Sanskar201/4-DOF-Robot-With-End-Manipulator/CAD Model/RoboticArm_4DOF/Railbase1.SLDPRT

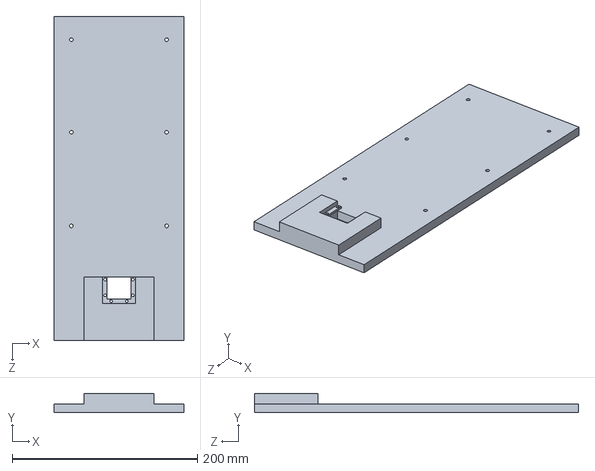
[picture p12: CAD file, 2024-12-22]
CAD Model/RoboticArm_4DOF/Railbase1.SLDPRT
140.0 x 20.7 x 350.0 mm
