Sanskar201/4-DOF-Robot-With-End-Manipulator/CAD Model/RoboticArm_4DOF/arm1.SLDPRT

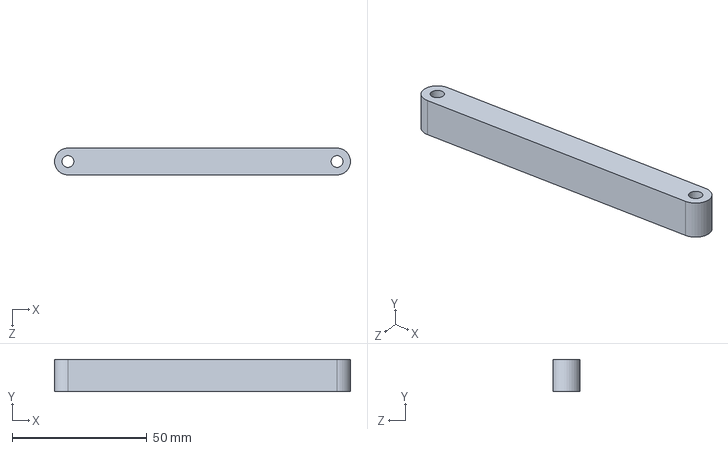
[picture p13: CAD file, 2024-12-22]
CAD Model/RoboticArm_4DOF/arm1.SLDPRT
110.0 x 12.0 x 10.0 mm
