Sanskar201/4-DOF-Robot-With-End-Manipulator/CAD Model/RoboticArm_4DOF/Gripper_Base.SLDPRT

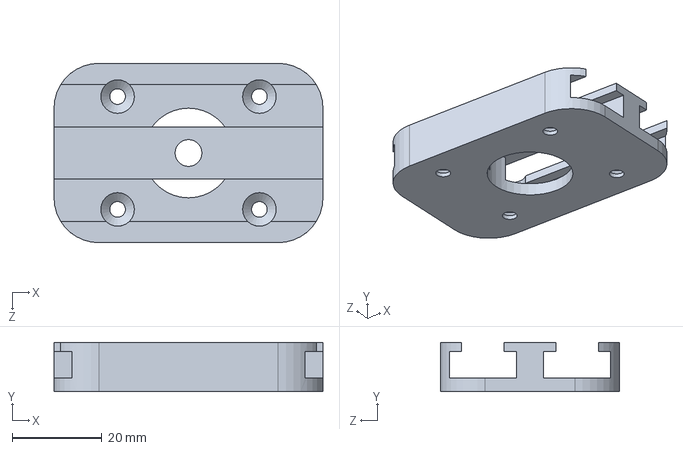
[picture p14: CAD file, 2024-12-22]
CAD Model/RoboticArm_4DOF/Gripper_Base.SLDPRT
60.0 x 11.0 x 40.0 mm
