Sanskar201/4-DOF-Robot-With-End-Manipulator/CAD Model/RoboticArm_4DOF/Pivot.SLDPRT

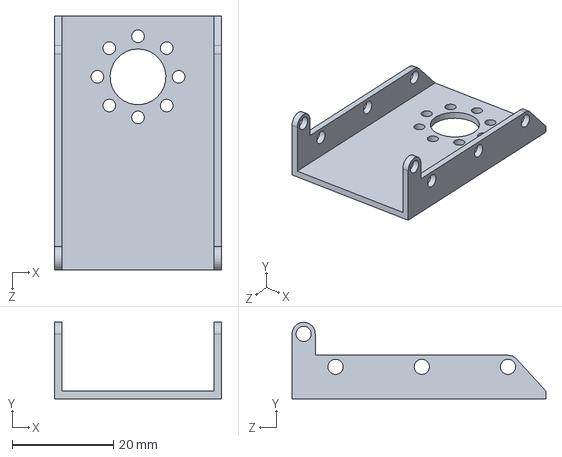
[picture p15: CAD file, 2024-12-22]
CAD Model/RoboticArm_4DOF/Pivot.SLDPRT
33.0 x 15.1 x 50.1 mm
