Sanskar201/4-DOF-Robot-With-End-Manipulator/CAD Model/RoboticArm_4DOF/Gripper_Link.SLDPRT

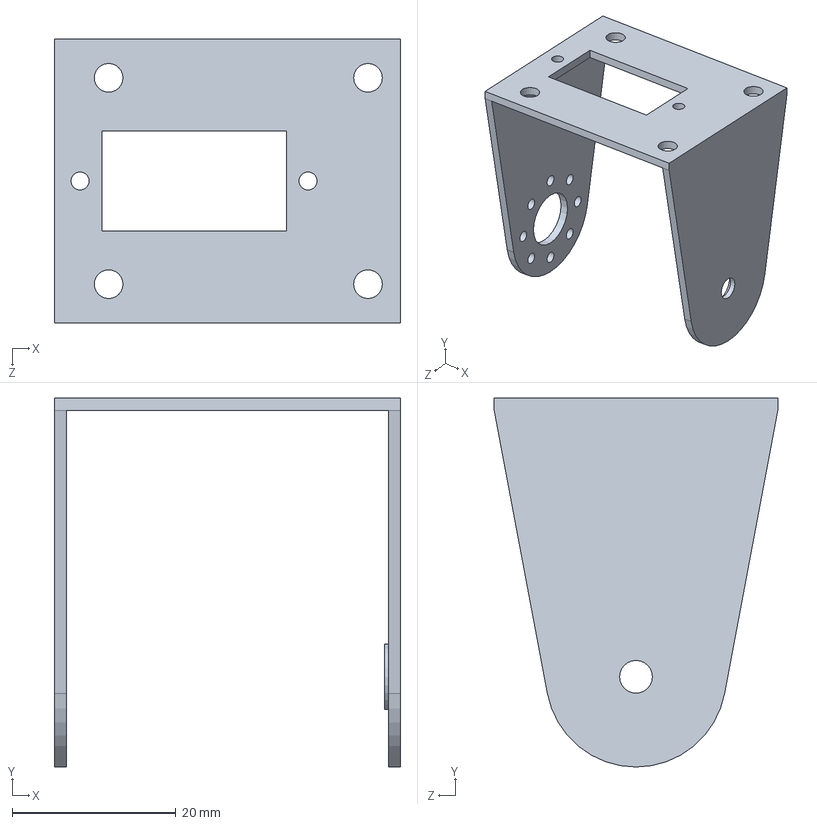
[picture p16: CAD file, 2024-12-22]
CAD Model/RoboticArm_4DOF/Gripper_Link.SLDPRT
42.2 x 45.0 x 34.6 mm
