Sanskar201/4-DOF-Robot-With-End-Manipulator/CAD Model/RoboticArm_4DOF/ServoSpacer.SLDPRT

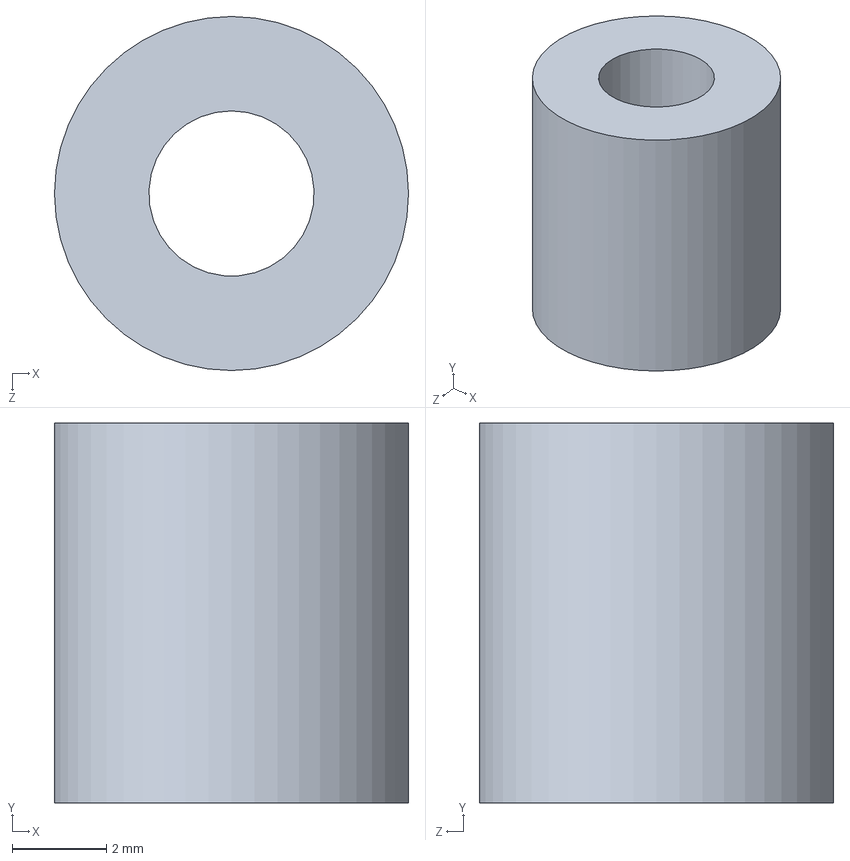
[picture p17: CAD file, 2024-12-22]
CAD Model/RoboticArm_4DOF/ServoSpacer.SLDPRT
7.50 x 8.05 x 7.50 mm
