Sanskar201/4-DOF-Robot-With-End-Manipulator/CAD Model/RoboticArm_4DOF/Gripper_rack1.SLDPRT

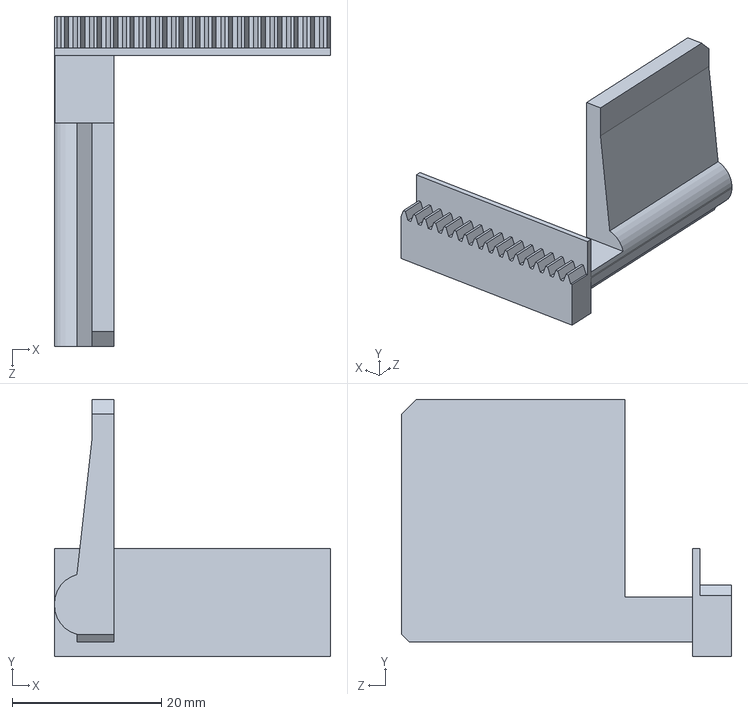
[picture p18: CAD file, 2024-12-22]
CAD Model/RoboticArm_4DOF/Gripper_rack1.SLDPRT
37.0 x 34.5 x 44.2 mm
