Sanskar201/4-DOF-Robot-With-End-Manipulator/CAD Model/RoboticArm_4DOF/SG90 - Micro Servo 9g - Tower Pro.1.SLDPRT

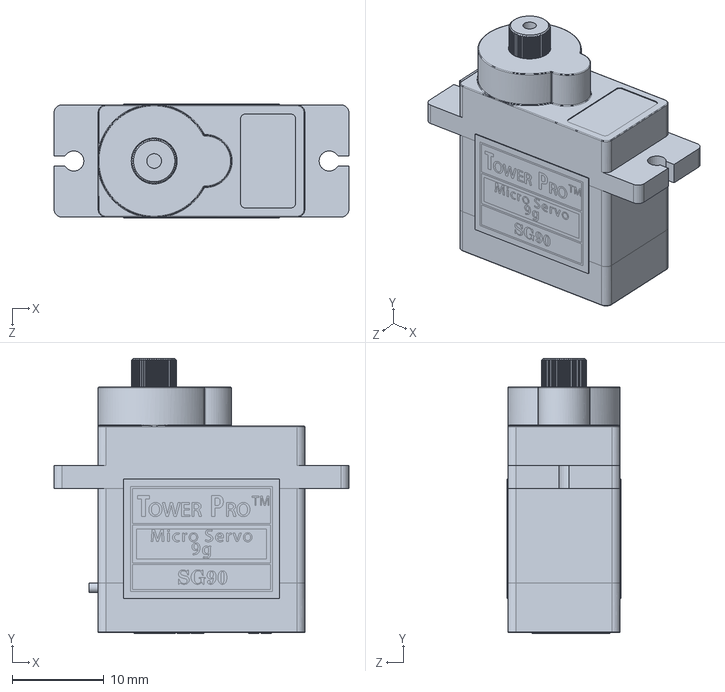
[picture p19: CAD file, 2024-12-22]
CAD Model/RoboticArm_4DOF/SG90 - Micro Servo 9g - Tower Pro.1.SLDPRT
32.1 x 30.0 x 12.4 mm
