Sanskar201/4-DOF-Robot-With-End-Manipulator/CAD Model/RoboticArm_4DOF/LinkReinforced.SLDPRT

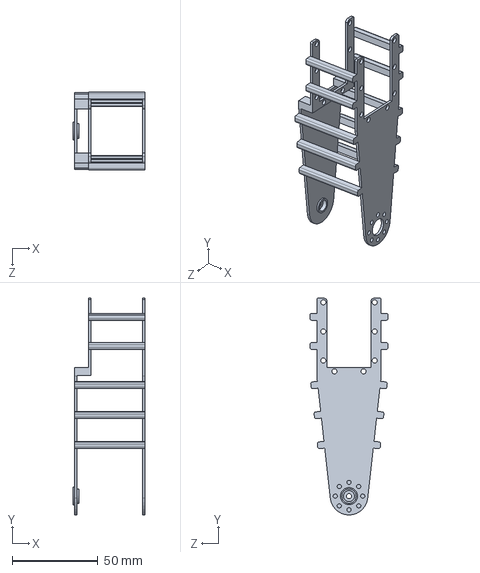
[picture p20: CAD file, 2024-12-22]
CAD Model/RoboticArm_4DOF/LinkReinforced.SLDPRT
42.2 x 126.6 x 45.6 mm
