Sanskar201/4-DOF-Robot-With-End-Manipulator/CAD Model/RoboticArm_4DOF/Base Updated.SLDPRT

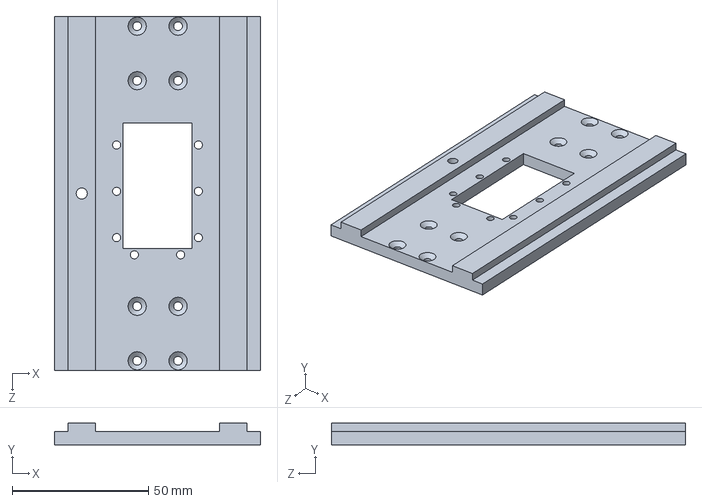
[picture p21: CAD file, 2024-12-22]
CAD Model/RoboticArm_4DOF/Base Updated.SLDPRT
75.6 x 8.00 x 130.0 mm
