Sanskar201/4-DOF-Robot-With-End-Manipulator/CAD Model/RoboticArm_4DOF/MX-28AT_AR.SLDPRT

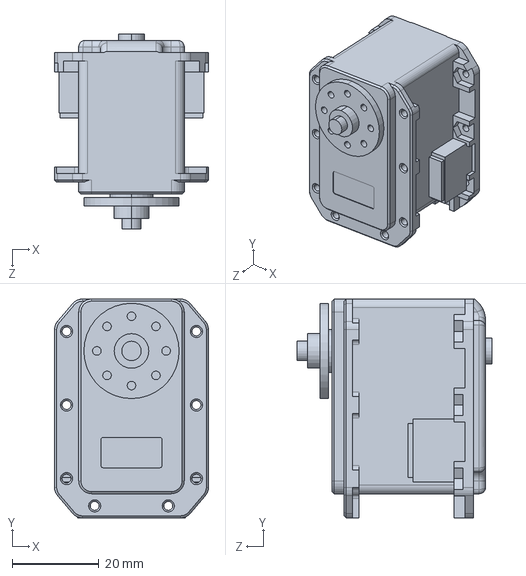
[picture p22: CAD file, 2024-12-22]
CAD Model/RoboticArm_4DOF/MX-28AT_AR.SLDPRT
35.6 x 50.6 x 45.1 mm
