Sanskar201/4-DOF-Robot-With-End-Manipulator/CAD Model/RoboticArm_4DOF/arm2.SLDPRT

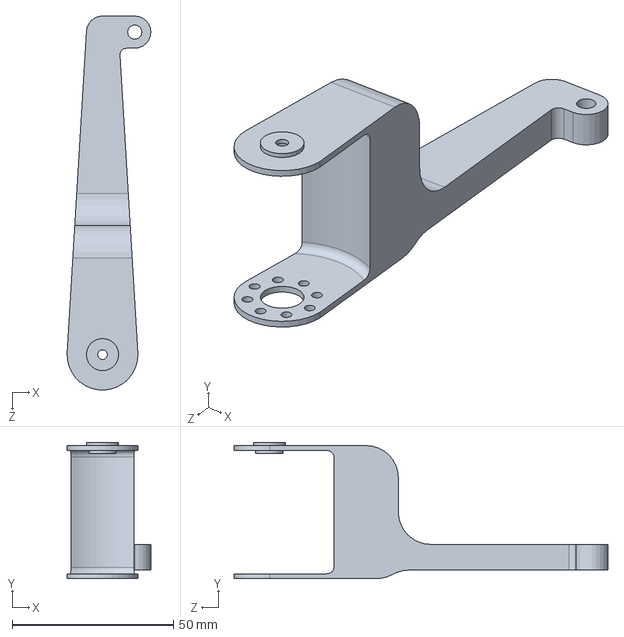
[picture p23: CAD file, 2024-12-22]
CAD Model/RoboticArm_4DOF/arm2.SLDPRT
26.0 x 42.2 x 116.0 mm
