Sanskar201/4-DOF-Robot-With-End-Manipulator/CAD Model/RoboticArm_4DOF/Link2Reinforced.SLDPRT

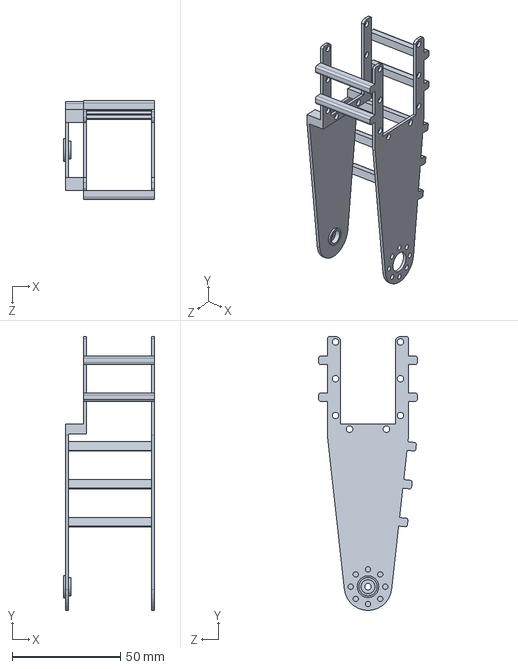
[picture p24: CAD file, 2024-12-22]
CAD Model/RoboticArm_4DOF/Link2Reinforced.SLDPRT
42.2 x 126.6 x 45.6 mm
