Sanskar201/4-DOF-Robot-With-End-Manipulator/CAD Model/RoboticArm_4DOF/92981A145_Alloy Steel Shoulder Screws.SLDPRT

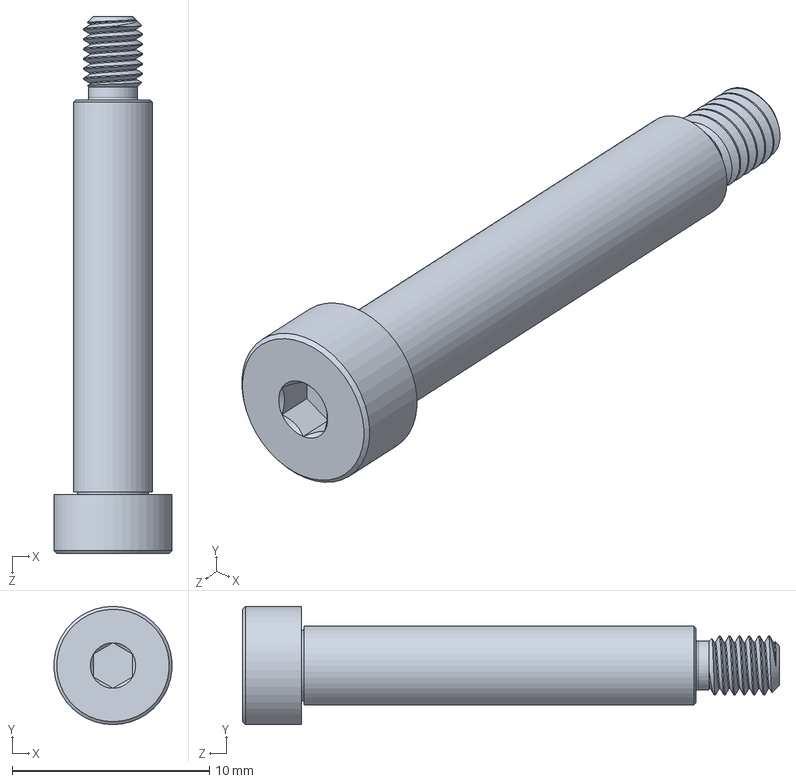
[picture p25: CAD file, 2024-12-22]
CAD Model/RoboticArm_4DOF/92981A145_Alloy Steel Shoulder Screws.SLDPRT
5.98 x 6.00 x 27.2 mm
