Sanskar201/4-DOF-Robot-With-End-Manipulator/CAD Model/RoboticArm_4DOF/6709K169_320 mm Long x 12 mm Wide Standard Guide Rail for Ball Bearing Carriage.SLDPRT

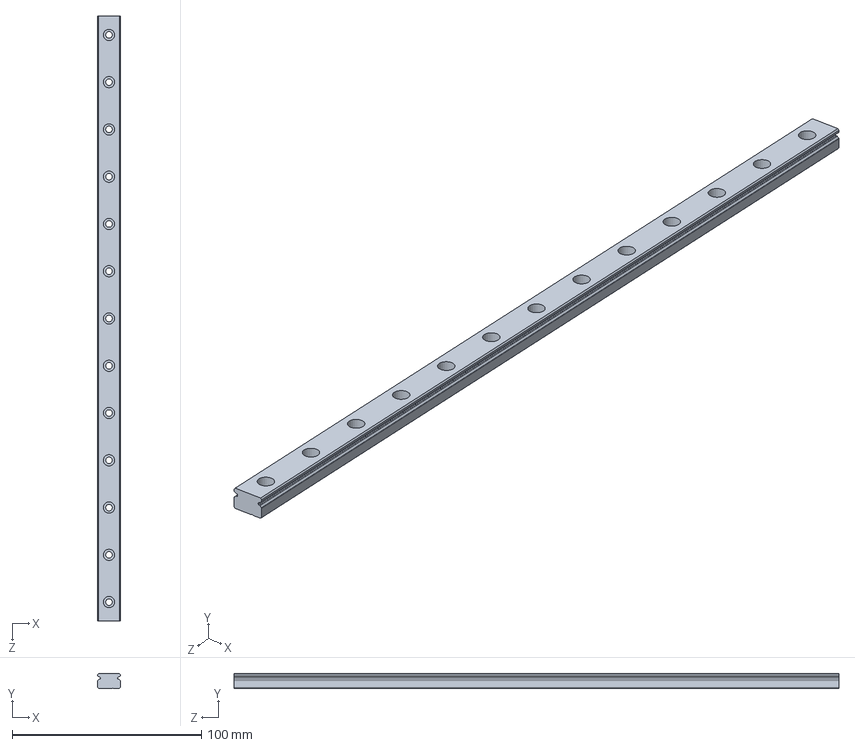
[picture p26: CAD file, 2024-12-22]
CAD Model/RoboticArm_4DOF/6709K169_320 mm Long x 12 mm Wide Standard Guide Rail for Ball Bearing Carriage.SLDPRT
12.0 x 8.00 x 320.0 mm
